JuanPablo2905/PROYECTO-PENDULO/hardware/pcb.jpeg

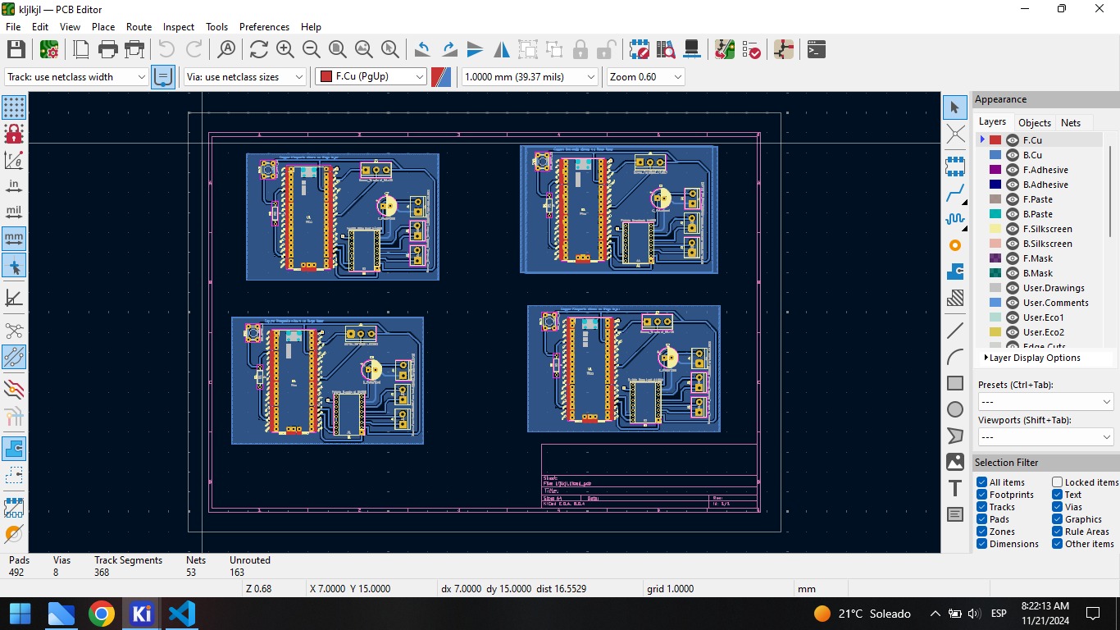
hardware/pcb.jpeg
