JuanPablo2905/PROYECTO-PENDULO/mechanical/readme.md

DISEÑOS e IMPRESIONES en 3D utilizadas en el proyecto

El archivo proyecto 2333.stl contiene el pendulo y brazo del proyecto 

Y el archivo IMPRIMIR.stl contiene el brazo utilizada en la version final
