JuanPablo2905/PROYECTO-PENDULO/hardware/readme.md

ESQUEMATICOS y PCB utilizado en el proyecto
