JuanPablo2905/PROYECTO-PENDULO/docs/PROYECTO_FINAL.thegoodone.pdf

# Pendulo invertido ´

1ero Lautaro Valentin Cabeza lautarovalentincabeza@impatrq,com

¿ 2do Luca Sturla
lucasturla@impatrq.com,

3ero Natanael Robaina
natanaelrobaina@impatrq,com

4th Juan Pablo Rodriguez
juanpablorodriguez@impatrq.com

5th Mateo Coria Reartes
mateocoriareartes@imptrq.com

Abstract—El proyecto consiste en equilibrar un pendulo en 90° ´ mediante el movimiento de un brazo que esta conectado a un ´ motor.

I. INTRODUCCION´
Elegimos este proyecto porque consist´ıa principalmente en un sistema de control de una variable, que en este caso era el
equilibrio del pendulo. Nos llam ´ | o especialmente la atenci ´ | on el ´
sistema de lazo cerrado implementado en el sistema. Durante
el proceso de investigacion, tambi ´ | en descubrimos la aplicaci ´ | on´
del control PID, lo que nos permitio adentrarnos en este ´ campo.
Originalmente, la idea planteada era levantar el pendulo ´ desde abajo y equilibrarlo. Sin embargo, debido a la complejidad que esto presentaba, nos enfocamos en equilibrar el
pendulo desde una posici ´ | on inicial, que ser ´ | ´ıa la referencia y la
posicion que quer ´ | ´ıamos que mantuviera a lo largo del tiempo.
Las principales complicaciones que enfrentamos fueron las imprecisiones en las mediciones del ADC de la Raspberry Pi
Pico, ya que, incluso con el pendulo inm ´ | ovil, las lecturas ´ | uc-
tuaban signicativamente. Durante el desarrollo del codigo, ´
tambien nos encontramos con di ´ | cultades al implementarlo
completamente desde cero y sin valores predenidos para las constantes del PID. Tuvimos que realizar multiples pruebas ´ hasta aproximarnos a los valores ideales.
Otras complicaciones que enfrentamos fueron mas estruc- ´ turales. Esto se debio a que las roscas realizadas en las piezas ´ impresas en 3D, con el tiempo, terminaron desgastandose. ´ Como consecuencia, el movimiento del motor no se reejaba en el brazo, ya que el acoplamiento se deslizaba y perd´ıa efectividad.

II. DESCRIPCION FUNCIONAL ´
A. Descripcion de circuitos
El circuito se compone principalmente de un potenciometro multivuelta, que funciona como elemento sensor de angulo, es multivueltas especicamente para medir la totalidad de la rotacion del pendulo.
Utilizamos el driver a4988 para poder darle instrucciones al motor, alimentado con 12V, y le seteamos una VREF de 0,48 para poder limitar la corriente por bobina a 0,6A y asi evitar que le llegue mas corriente que la debida al motor.
Usamos una fuente STEP-DOWN para poder alimentar el driver, ya que se uso de fuente un cargador de notebook.

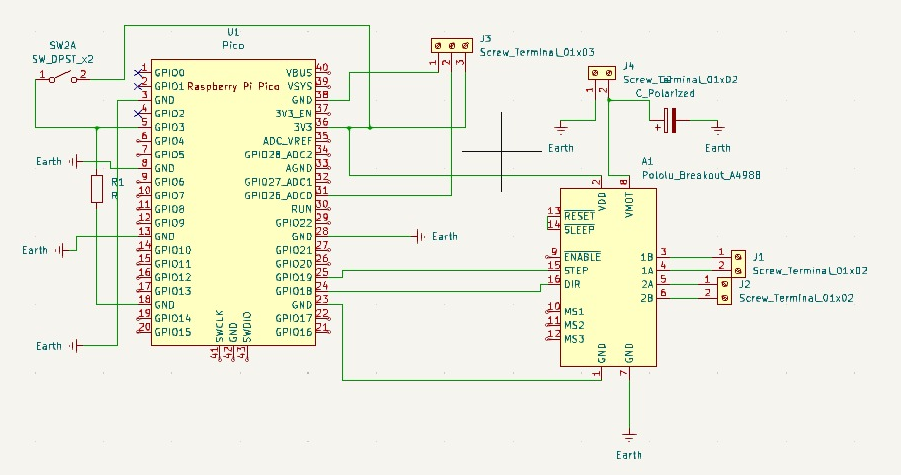
[picture p2: figure]

Fig. 1. ESQUEMATICO

Conectamos un pin entre V-BUS y MS1 del driver para poder sacar provecho del microstepping que ofrece el driver, que en ese caso era de 1/2 paso. Los circuitos se pueden ver en la Figura 1
B. DIAGRAMA EN BLOQUES
C. Diagrama de codigo ´
A lo largo del codigo, implementamos la formula del control PID con el n de poder extraer una senal que nos indique el ˜ giro y la velocidad con la que se deberia mover el motor:

u(t) = Kpe(t) + Ki

- t

0

e(τ ) dτ + Kd

d
dt e(t) (1)

Ademas se incluyo un boton para poder guardar una referencia, ya que en nuestro sensor, los 90° no siempre iban a estar en el mismo lugar. Y con el n de que el motor no siga girando cuando el pendulo se cae,se implemento un rango de deteccion de caidas, en el que en el caso de estar dentro de ese rango, se detendra todo y se esperara a que se setee una nueva referencia.
No se implemento un promedio de mediciones del ADC ya que aunque mejoraria las mediciones, es mas dicultoso balancear un pendulo que en las que se toma en cuenta mediciones pasadas y no las mas presentes. Figura 3

III. ALCANCE LOGRADO
Logramos unos segundos de estabilidad, que pod´ıan extenderse un poco mas con la ayuda de topes. Sin embargo, ´ debido a las problematicas mencionadas anteriormente, no ´ conseguimos que el sistema fuera constante ni que pudiera

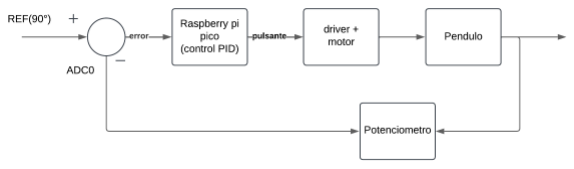
[picture p3: figure]

Fig. 2. Diagrama en bloques
- 1ero:Seteamos la referencia a 90°
- 2ndo:El error llega la Raspberry pi pico, que es el encargado de determinar la velocidad del motor dependiendo del error que puede haber provenido del elemento sensor. Esto lo hace con la senal de control proveniente de la ˜ etapa del control PID.
Luego de multiples pruebas, los valores que usamos nalmente fueron:
– Kp(Ganancia proporcional)=25
– Ki(Ganancia integral)=0.3
– Kd(Ganancia derivativa)=0.1
- 3ero: Esta senal de control es enviada al driver a4988, ˜ que es el encargado de ,segun la senal de control, darle ˜ una velocidad especica variando el ancho de pulsos que es enviado al motor.Ademas de controlar la velocidad del motor, le da la direccion de giro. El motor usado fue un NEMA 17, que es un motor paso a paso.
- 4to: Todo esto se vera reejado en el pendulo que es el objeto que queremos lograr un control en su equilibrio.
- 5to: Particularmente el sensor usado es un potenciometro multivueltas.

corregir los errores introducidos al mover el pendulo manual- ´
mente. Quizas nos acercamos a los valores ´ | optimos del PID ´
para el pendulo, pero de ´ | nitivamente no eran exactos.
El control PID logro estabilizar el p ´ | endulo durante breves ´
per´ıodos, pero el sistema no fue capaz de mantener la estabilidad durante tiempos prolongados. La imprecision en las ´ lecturas del sensor y el desgaste de las piezas impresas fueron factores que contribuyeron a la inestabilidad.

IV. CONCLUSIONES
En denitiva, a lo largo del trayecto adquirimos una gran variedad de conocimientos, pero, al reexionar retrospectivamente, identicamos aspectos que podr´ıamos haber mejorado. Para empezar, podr´ıamos haber incorporado mas elementos ´ matematicos para guiarnos mejor al estructurar el sistema. ´ Ademas, habr ´ ´ıa sido util incluir una referencia externa con ´ un regulador para la Raspberry Pi Pico, lo que nos habr´ıa
permitido obtener mediciones mas precisas del ´ | angulo. ´
Otro error que cometimos fue en la eleccion del p ´ | endulo. ´
Hubiera sido mas conveniente utilizar un dise ´ | no en el que ˜
el peso se concentrara en la punta, mientras que el resto
fuera liviano y uniforme, como una varilla con un peso en
un extremo. Esto habr´ıa facilitado el control y mejorado el

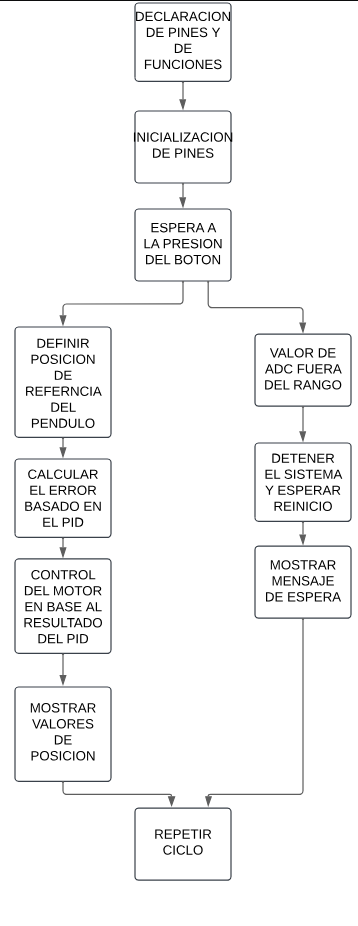
[picture p4: figure]

desempeno del sistema en general. ˜ | Fig. 3. DIAGRAMA DE CODIGO

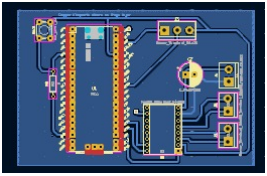
[picture p5: figure]

Fig. 4. PCB

Finalmente, a pesar de las dicultades, el proyecto nos permitio aprender acerca de la importancia de los sistemas ´ de control, la implementacion de algoritmos PID y el manejo ´ de sensores, lo que representa una valiosa experiencia en ingenier´ıa.

V. ANEXOS
A. PCB
Figura 4
B. Repositorio del proyecto Link:https://github.com/JuanPablo2905/PROYECTO-PENDULO/tree/main
C. Lista de materiales
Para la estructura fuero utilizados los siguientes materiales:
- 2x placas de acr´ılico (20x10 cm)
- 1x lamina de metal (10x10 cm) ´
- 8x escuadras metalicas ´
- 1x placa de cobre (10x10 cm)
- 2x planchas de madera
- 2x impresiones en 3D
- 32x tornillos.
- 32x tuercas.
- Cables
D. Lista de componentes
- 1x Capactitor de 100uF x 50v.
- 1x Motor paso a paso NEMA 17 17hs2408.
- 3x Tiras de pines hembra.
- 1x Raspberry Pi pico.
- 1x Driver a4988.
- 1x Boton.
- 1x Resistencia de 10kohms.
- 3x Bornera de 2 pines
- 1x Bornera de 3 pines
