JuanPablo2905/PROYECTO-PENDULO/hardware/esquematico.jpeg

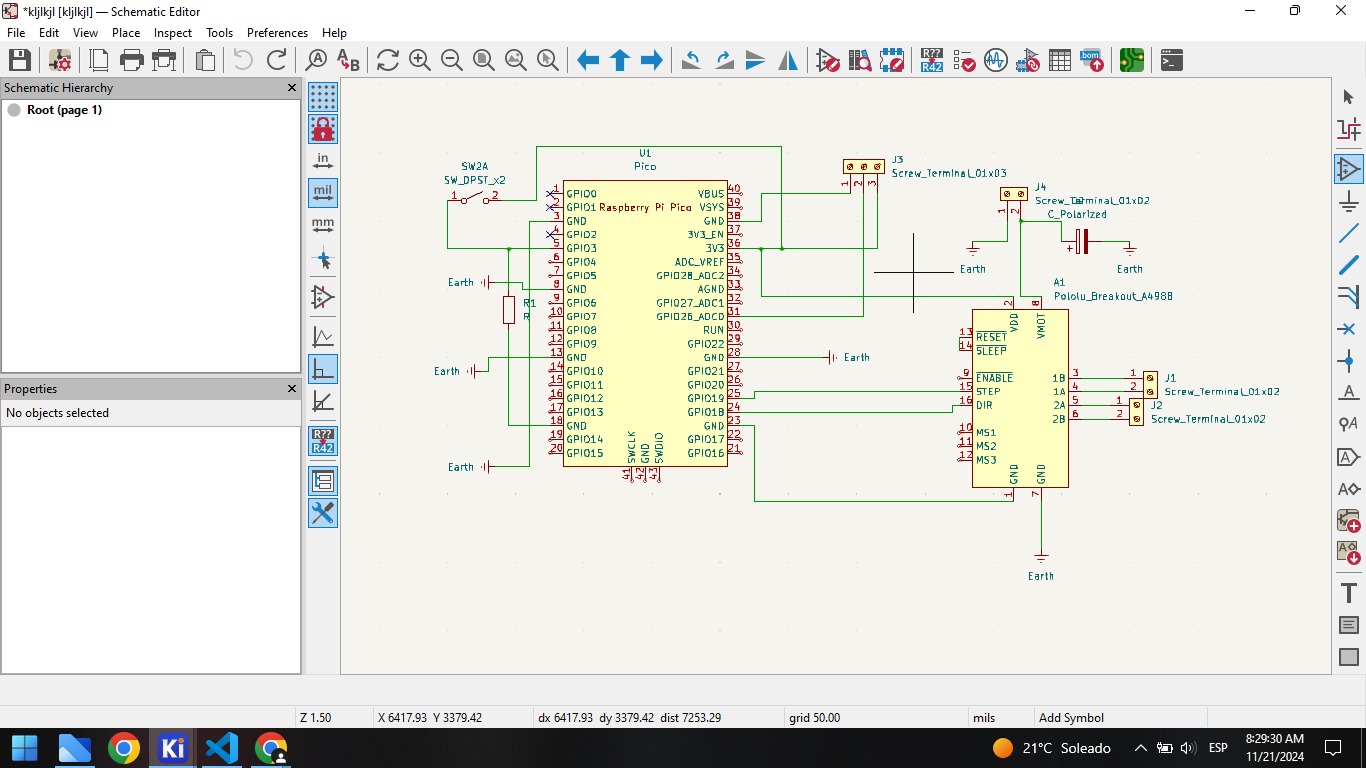
hardware/esquematico.jpeg
