JuanPablo2905/PROYECTO-PENDULO/mechanical/PROYECTO2333.stl

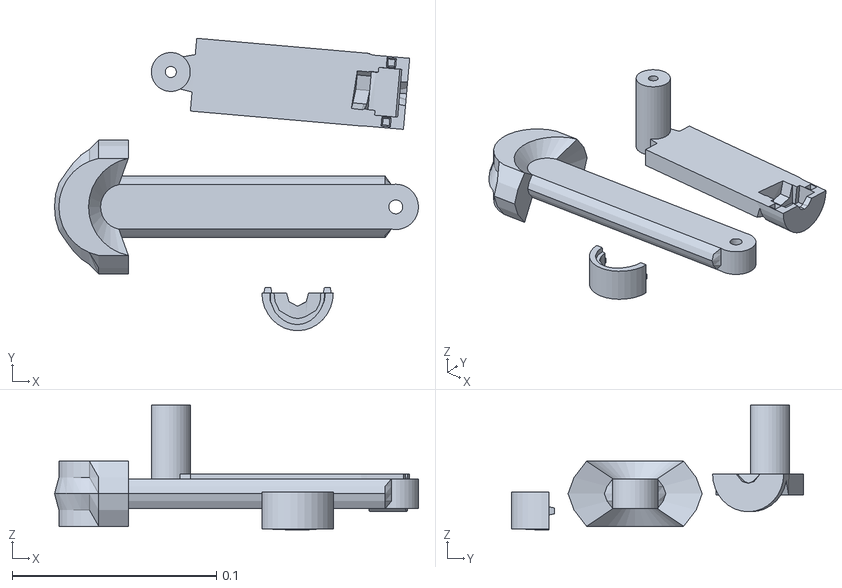
[picture p8: CAD file, 2024-11-28]
mechanical/PROYECTO2333.stl
0.178 x 0.143 x 0.061
