JuanPablo2905/PROYECTO-PENDULO/mechanical/IMPRIMIR.stl

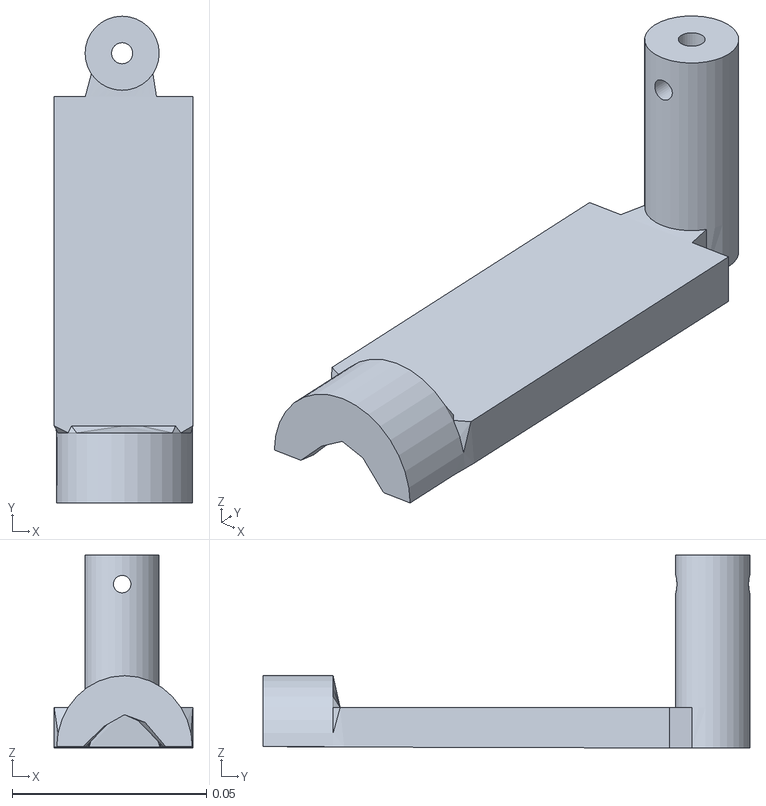
[picture p9: CAD file, 2024-11-27]
mechanical/IMPRIMIR.stl
0.0357 x 0.125 x 0.0497
