JuanPablo2905/PROYECTO-PENDULO/(list of files, cad)

Other CAD files:
mechanical/untitled.blend
