JuanPablo2905/PROYECTO-PENDULO/hardware/pcb_pendulo .pdf

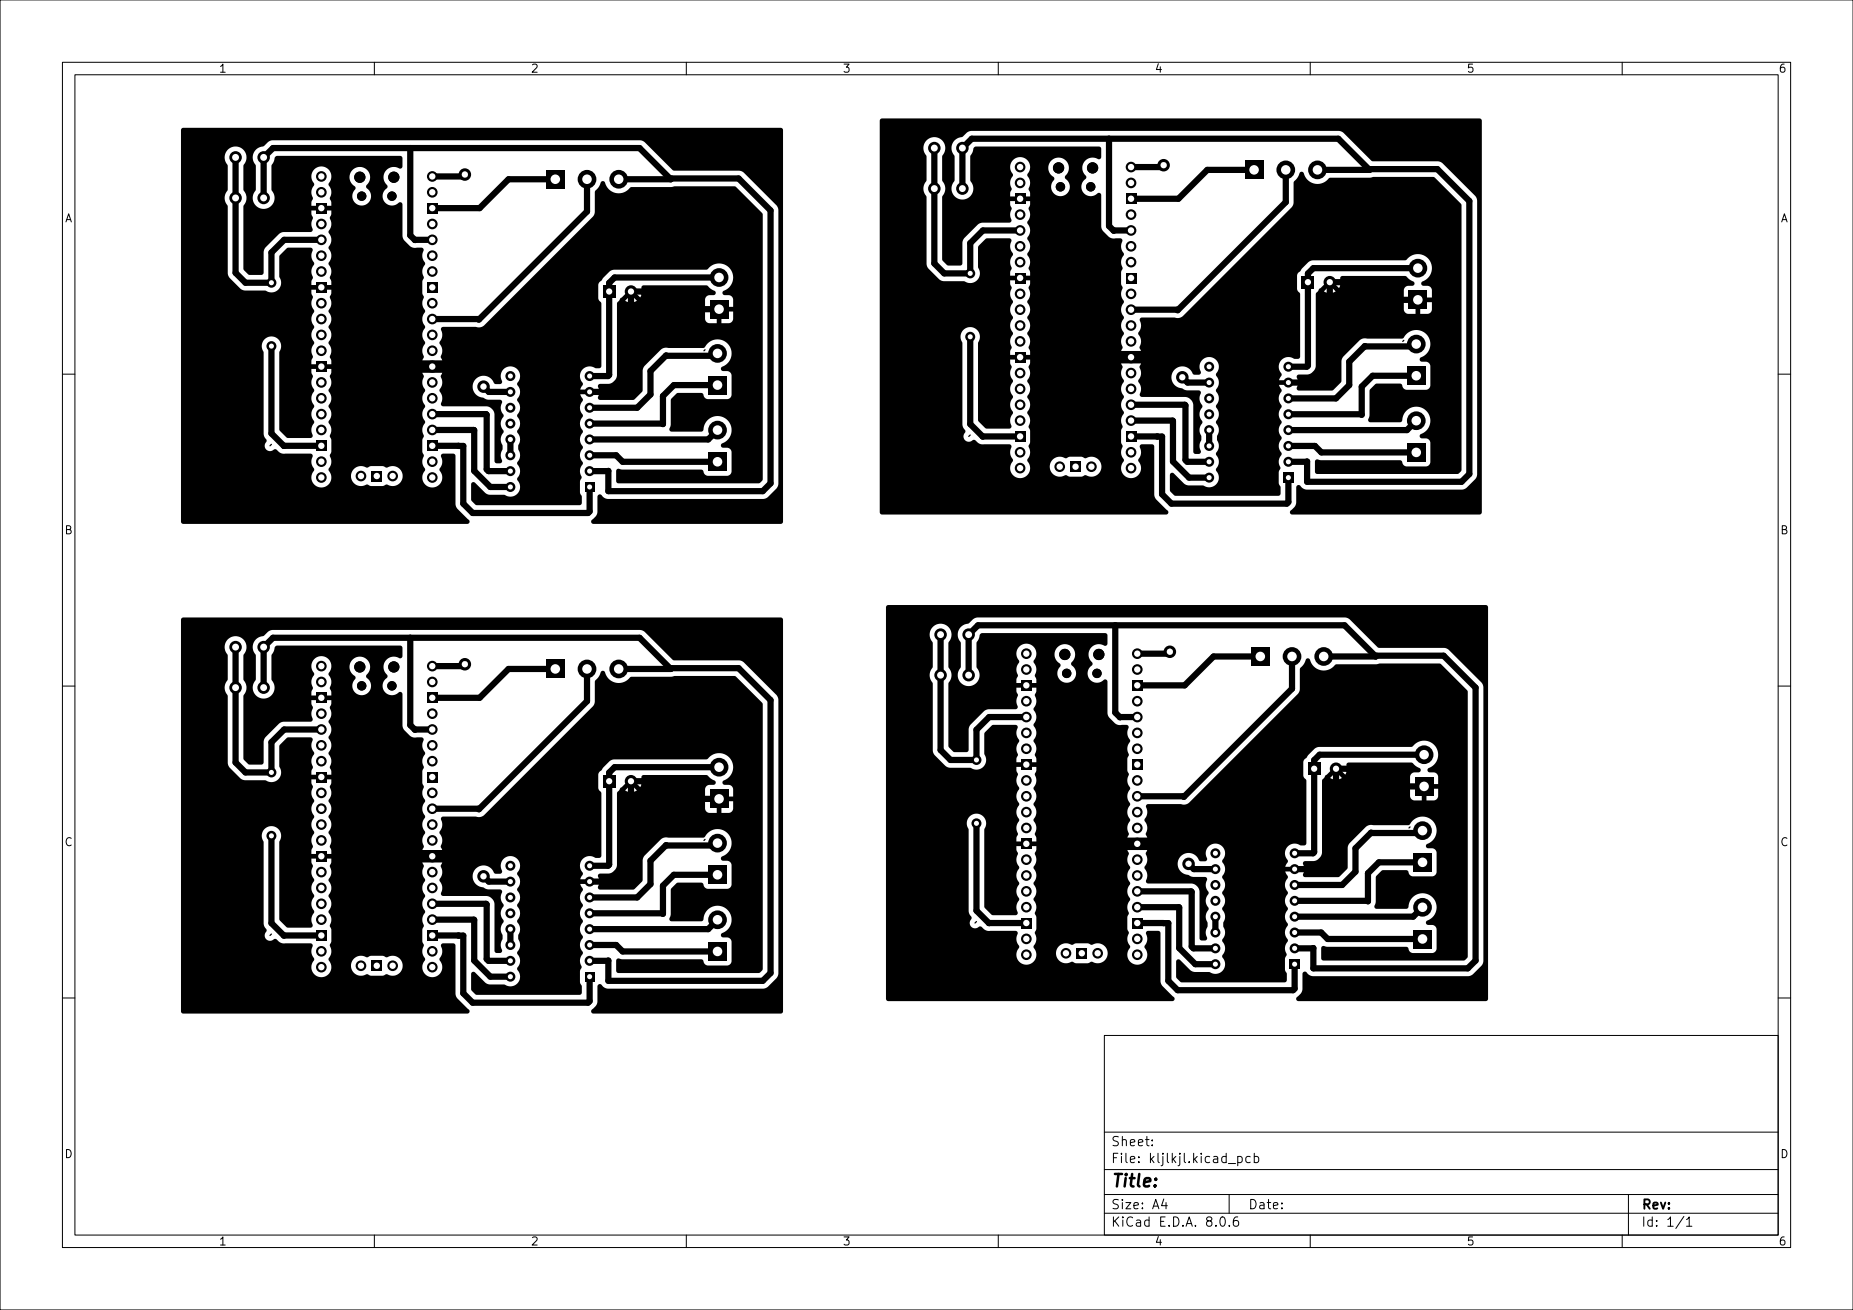
[picture p10: page 1]
